OE3GOD/NCDXF-Clock/docs/DSC_0188.jpg

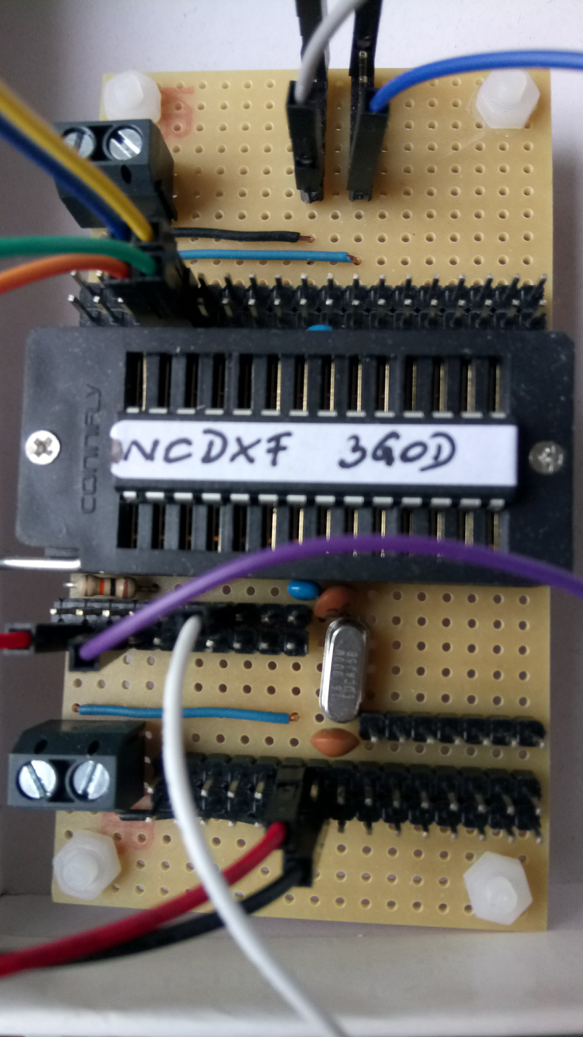
docs/DSC_0188.jpg
