OE3GOD/NCDXF-Clock/docs/DSC_0118.jpg

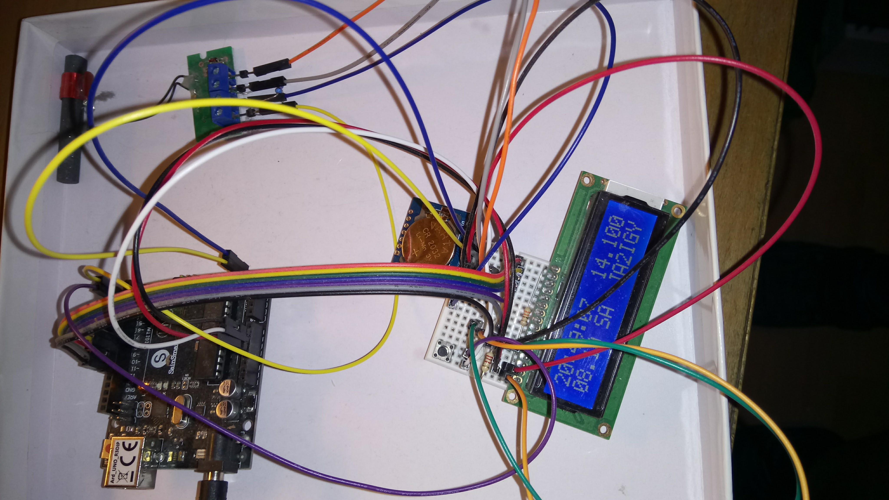
docs/DSC_0118.jpg
