OE3GOD/NCDXF-Clock/README.md

# NCDXF-Clock
UTC Clock for the Shack and gives Info on the NCDXF Beacons using DCF77 and RTC

Uses
Arduino Uno

RTC Module (by Semaf electronics Vienna)

DCF77 Module (by Conrad electronics Vienna)

I2C LCD Display (16 x 2) (by Semaf electronics Vienna)
