OE3GOD/NCDXF-Clock/docs/DCF77 Funkuhr OE3GOD.docx

# DCF77 gesteuerte Stationsuhr und NCDXF-Bakenmonitor

Gerald Moritz, OE3GOD

Zusammenfassung

Seit mehr als zehn Jahren gibt es den „Arduino“ am Markt. Dabei handelt es sich um eine Mikrocontrollerentwicklungsplattform, die wegen ihrer einfachen Handhabung immer beliebter wird.

Im Internet findet man dafür vermehrt sehr interessante Anwendungen auch für den Amateurfunk. Als Einstieg wurde nach einem Projekt gesucht, das mich näher an diese Thematik heranführt aber bereits an der Funkstation einen wertvollen Beitrag leistet. Durch meine Beobachtungen des 10m Bandes kam dann rasch auch der Wunsch auf, den Sendeplan der NCDXF-Baken gemeinsam mit der Uhrzeit anzuzeigen.

DCF77

Vom Standort Mainflingen bei Frankfurt am Main werden auf der Frequenz 77,5 kHz bereits seit 1959 Zeitzeichen gesendet. Dabei wird das Trägersignal (50 KW) für 0,1 bzw 0,2 Sekunden auf 15% herabgesenkt.

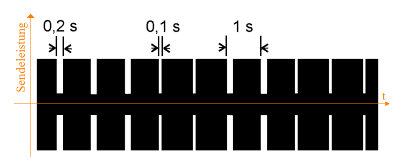
[picture p3: figure]
DCF77 Impulse

Die binäre Kodierung erfolgt dabei über die Länge der Absenkung.

0,1 Sekunde = binär 0

0,2 Sekunden = binär 1

Die Bedeutung der einzelnen Werte ist in der folgenden Zeittafel abgelegt. Insgesamt werden 59 „Werte“ übertragen, in der Sekunde 59 erfolgt keine Absenkung.

Die Werte von 0 bis 14 enthalten Lizenzpflichtige Wetterdaten bzw. Alarmierungsdaten im Katastrophenfall, zwischen 15 und 20 gibt es die Werte für die Zonenzeit (MEZ/MESZ) und etwaige Schaltsekunden, die eigentliche Zeit- und Datumskodierung beginnt ab Sekunde 20. Dabei werden die Werte immer im Voraus gesendet und mit der Sekunde 0 beginnt diese Minute.

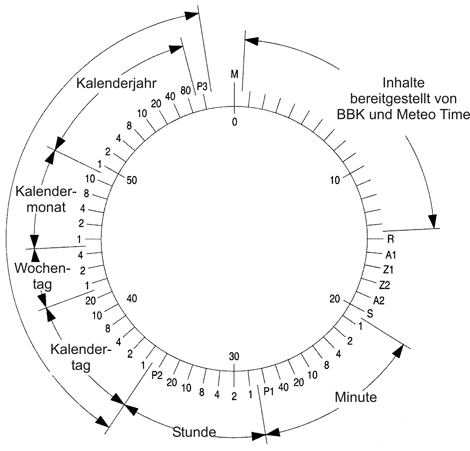
[picture p4: figure]

Beispiel für die BCD-Kodierung des Kalenderjahrs 2016:

1 | 2 | 4 | 8 | 10 | 20 | 40 | 80
0 | 1 | 1 | 0 | 1 | 0 | 0 | 0

(0 * 1) + (1 * 2) + (1 * 4) + (0 * 8) + (1*10) + (0 * 20) * (0 * 40) + (0 * 80) = 16

Die NCDXF-Baken

Das Bakennetz der DX-Foundation von Nord Kalifornien (NCDXF) besteht aus 18 zeitsynchronisierten Sendern, welche das Rufzeichen und ein Trägersignal mit unterschiedlichen Ausgangsleistungen senden.

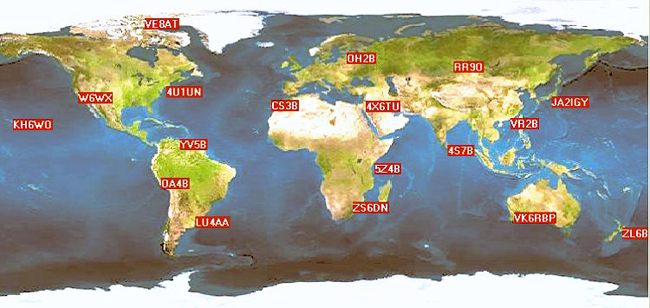
[picture p5: figure]
worldmap

Das Rufzeichen wird mit ca. 22 WpM mit 100 Watt gesendet, danach erfolgt ein 1 Sekunden Träger mit je 10 Watt, 1 Watt und 100 mW. Insgesamt arbeiten diese 18 (GPS gesteuerten) Sender je 10 Sekunden auf den jeweiligen Frequenzen, somit kann man innerhalb von 3 Minuten (180 Sekunden) die Ausbreitungsbedingungen überprüfen.

Der Sendeplan beginnend bei Sekunde Null zur vollen Stunde.

Call
4U1UN | 1 | 2 | 3 | 4 | 5
VE8AT | | 1 | 2 | 3 | 4 | 5
W6WX | | | 1 | 2 | 3 | 4 | 5
KH6RS | | | | 1 | 2 | 3 | 4 | 5
ZL6B | | | | | 1 | 2 | 3 | 4 | 5
VK6RBP | | | | | | 1 | 2 | 3 | 4 | 5
JA2IGY | | | | | | | 1 | 2 | 3 | 4 | 5
RR9O | | | | | | | | 1 | 2 | 3 | 4 | 5
VR2B | | | | | | | | | 1 | 2 | 3 | 4 | 5
4S7B | | | | | | | | | | 1 | 2 | 3 | 4 | 5
ZS6DN | | | | | | | | | | | 1 | 2 | 3 | 4 | 5
5Z4B | | | | | | | | | | | | 1 | 2 | 3 | 4 | 5
4X6TU | | | | | | | | | | | | | 1 | 2 | 3 | 4 | 5
OH2B | | | | | | | | | | | | | | 1 | 2 | 3 | 4 | 5
CS3B | 5 | | | | | | | | | | | | | | 1 | 2 | 3 | 4
LU4AA | 4 | 5 | | | | | | | | | | | | | | 1 | 2 | 3
OA4B | 3 | 4 | 5 | | | | | | | | | | | | | | 1 | 2
YV5B | 2 | 3 | 4 | 5 | | | | | | | | | | | | | | 1

1 = 14.100 kHz | 2 = 18.110 kHz | 3 = 21.150 kHz | 4 = 24.930 kHz | 5 = 28.200 kHz

Zu allen anderen Zeiten erfolgt keine Aussendung.

Die Schaltungsbeschreibung

Begonnen wurde dieses Projekt mit einem Arduino kompatiblen „SainSmart UNO R3 DIP ATMega328“, da er zum Zeitpunkt der Anschaffung günstig und lagernd war. Mittlerweile wird diese Platine nur noch zum Programmieren eigener ATMEGA328PU verwendet. Bei einem Misserfolg ist der finanzielle Schaden von ca. € 3,60 für einen einzelnen Chip minimal.

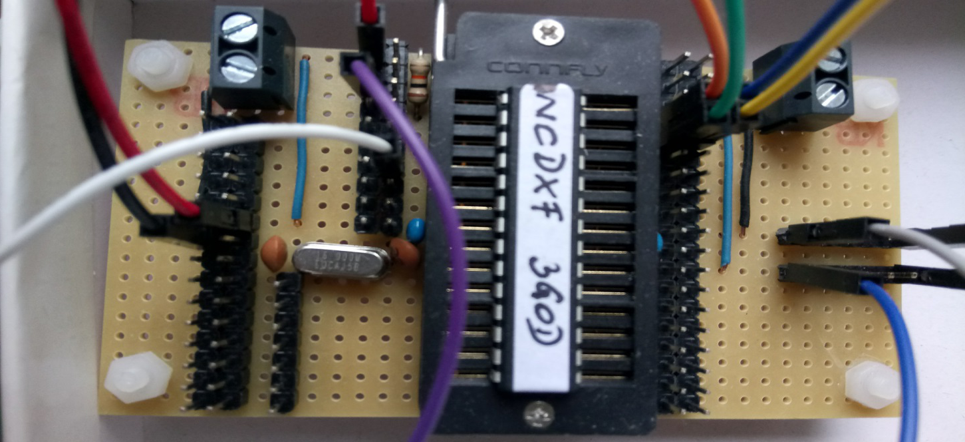
[picture p6: figure]

Um diesen Chip zum Laufen zu bringen braucht man neben der 5V Stromversorgung nur noch einen 16MHz Quarz und 2 x 22 pF Kondensatoren und hat einen platzsparenden Mikrocontroller für Aufgaben in den unterschiedlichsten Gebieten.

Taster für Bandwahl

Arduino

(UNO)

DCF77

Empfänger

LCD Display

2 x 16 Zeichen

(I²C)

DS1307

Uhrenmodul

(I²C)

Mit dem Einschalten wird zuerst geprüft, ob das Uhrenmodul vorhanden ist und ob eine Zeitinformation bereits gespeichert wurde. Im Fehlerfall wird eine Meldung angezeigt und mit dem Empfang des DCF77 Signals begonnen. Sollte eine Uhrzeit gespeichert sein, so wird diese in den Speicher geholt und angezeigt. Somit wird auch der aktuelle Bakensender ermittelt.

Abhängig von der Uhrzeit und dem eingestellten Band wird das sendende Rufzeichen berechnet. Mit den 10 Sekunden dauernden Aussendungen der 18 Sender hat man innerhalb von drei Minuten einen Überblick über die aktuellen Ausbreitungsbedingungen.

Das Uhrenmodul hat eine (angebliche) Ungenauigkeit von einer Minute pro Jahr. Alle 15 Minuten wird die Uhrzeit des Arduino durch die DCF77-Uhrzeit aktualisiert. Zu jeder vollen Stunde wird die Uhrzeit im Uhrenmodul gespeichert (falls dieses vorhanden ist). Somit sollte die Ganggenauigkeit kein Problem mehr darstellen. Ein Betrieb ohne dem RTC ist möglich.

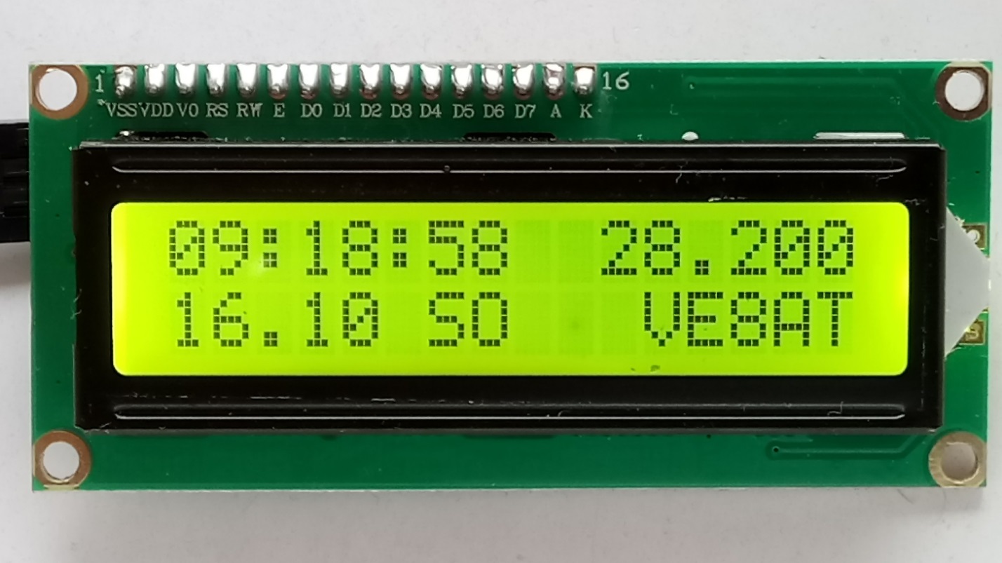
[picture p7: figure]

Beispiel der DCF77 Bakenanzeige

Am Sonntag, 16.10. um 09:18:58 (UTC) sendete VE8AT auf 28.200 kHz.

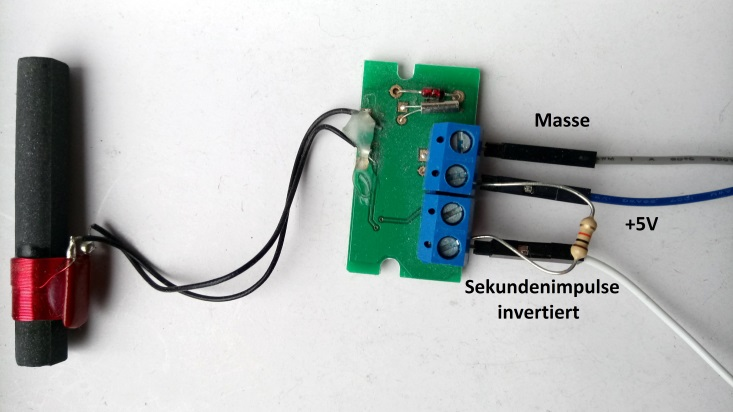
[picture p8: figure]

Viele Zeitprojekte arbeiten mit einem günstigen GPS-Modul, für den Beginn war mit die DCF77 Empfangsmöglichkeit etwas leichter zu realisieren. Der DCF77-Empfänger besteht aus einer Ferrit-Antenne und einer Miniaturplatine mit vier Anschlüssen:

1. GND
2. VCC (2,5V – 15V)
3. DCF-Ausgang
4. DCF-Ausgang invertiert

Ausgänge 3 und 4 haben einen offenen Kollektor, ein 10kOhm Pull-up Widerstand wurde verwendet.

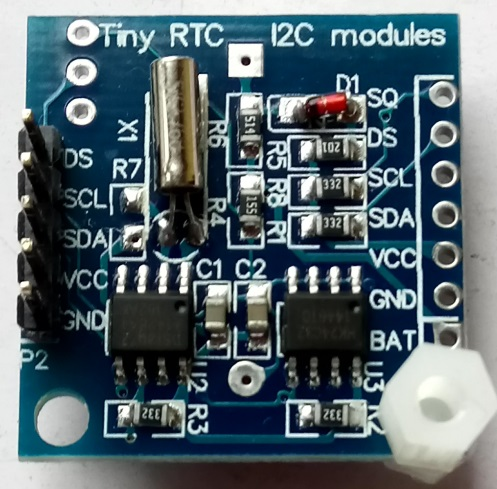
[picture p9: figure]

Das Uhrenmodul (DS1307) enthält neben der batteriegepufferten Uhr noch ein eEprom 4KByte zur freien Verwendung. Beide Teile (Uhr und Speicher) werden über den I²C-Bus angesprochen.

Über diese Zweidrahtleitung ist auch das LCD-Modul angeschlossen, da ansonsten viele der insgesamt 16 Anschlüsse am LCD-Modul zu verdrahten gewesen wären. Egal, ob die anzuzeigenden Daten über den I²C-Bus kommen, oder parallel, der Unterschied liegt nur in der Initialisierung am Beginn des Programms, die Befehle zur Anzeige sind in beiden Versionen gleich.

Die ersten Experimente machte ich mit einem (parallelen) blauen LCD-Display mit weißer Schrift. Bei der Verwendung eines I²C LCD-Moduls gibt es den Nachteil, daß die Display-Hintergrund Beleuchtung nicht dimmbar ist. Aber sogar bei hellstem Sonnenschein an der Funkstation ist die Uhrzeit und das aktuelle Bakenrufzeichen wunderbar zu lesen.

Da die Bakenstationen auf fünf Bändern senden, benötigte ich eine Umschaltung für die jeweiligen Frequenzen. In meiner Bastelkiste hatte ich einen kleinen Taster, mit diesem kann das gewünschte Bakenband ausgewählt werden. Mit einer größeren Anzeige wäre die Darstellung aller Rufzeichen auch ohne Umschaltung möglich.

Das „Blockschaltbild“ ist eigentlich bereits der gesamte Schaltplan, einzig der Pullup-Widerstand am DCF77-Modul ist nicht eingezeichnet. Die einzelnen Module erhalten ihre Spannungsversorgung vom Arduino (rot/schwarz), der I²C-Bus muss nicht von unterschiedlichen Pins zur Peripherie geführt werden, die Geräte können hintereinander geschaltet werden (gelb – SCL, orange - SDA).

Das DCF77 Modul (Pin 4) legt im Takt der ausgesendeten Impulse die Versorgungsspannung gegen Masse, daher auch der 10kOhm Widerstand (max. 1mA Schaltstrom). Am Pin3 kann über einen Transistor eine LED betrieben werden, die einzelnen Zeitimpulse (100 bzw. 200 Millisekunden) können damit sichtbar gemacht werden. Gleichzeitig kann aber auch der Empfang kontrolliert werden, im Falle einer Störung sieht man dann nur ein unkontrolliertes Aufflackern.

Für die Dekodierungsarbeit werden fertige Bibliotheken in den Code eingebunden, die man sich frei aus dem Internet holen kann. Zum Entziffern wird ein Interrupt verwendet (also eine Unterbrechung der bestehenden Verarbeitung) wenn das Signal vom Empfänger von High auf Low wechselt.

Nach dem Einschalten benötigt das Programm grundsätzlich mehrere Minuten, bis alle Zeitinformationen eingelangt sind. Wenn jedoch kein Empfang möglich ist (z.B. innerhalb des Hauses oder Störungen in der Umgebung, aber auch wenn der Zeitzeichensender wegen Defekt oder sonstigen Problemen nicht sendet) gibt es auch keine Information über die aktuell aktiven Baken.

Daher wurde die Grundschaltung um das günstige RTC (Real Time Clock) Modul DS1307 erweitert. Nach dem Ausschalten bleibt die Uhrzeit batteriegepuffert erhalten. Teurere Module bieten temperaturkompensierte Oszillatoren, diese sind aber für diese Anwendung nicht notwendig.

Apropos Versorgungsspannung: Die Programmierung inklusive der Spannungszufuhr erfolgt über die USB-Schnittstelle, beim Betrieb muß jedoch ein stabilisiertes Netzteil bzw. Batterie verwendet werden, bei USB-Versorgung hat die Uhr bisher nicht funktioniert. Für diesen Zweck hat die Arduino-Platine einen eigenen Stromanschluss (7-12 Volt). Aktuell gibt es diese Uhr nur als Prototyp, ein Gehäuse ist in Arbeit.

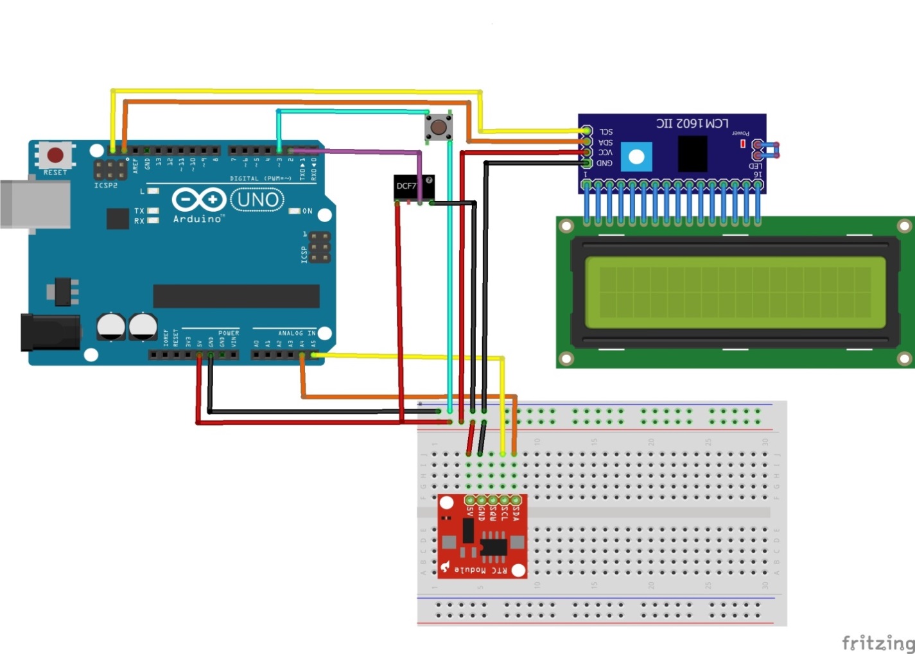
[picture p10: figure]

Anmerkungen zum Source-Code:

Dies ist mein erstes Arduino-Projekt, es kann sicherlich noch Unsicherheiten bei diversen Definitionen geben, diese werden im Laufe der Zeit sicher korrigiert und der Code verbessert werden.

Der Code kann auch auch vie email (oe3god@gmx.at) angefordert werden.

verwendete Bauteile:

SainSmart UNO R3 DIP ATMega328 Conrad ( 1359108 – 62)

bzw. ATMEGA 328P-PU Conrad (155197 – 62)

Kabel, Breadboard, Widerstände, Taster,

LCD-Display (blau/weiß) aus dem Paket

„Arduino Lernpaket Conrad Components

Arduino™ verstehen und anwenden“

Conrad (1384145 – 62)

DCF Empfänger Modul Conrad (641138 – 62)

DS1307 Real Time Clock Semaf electronics (ser00171)

I²C LCD Modul Semaf electronics (ser00054)

Quellen:

https://www.arduino.cc/

http://www.ptb.de/cms/ptb/fachabteilungen/abt4/fb-44/ag-442/verbreitung-der-gesetzlichen-zeit/dcf77/zeitcode.html

https://www.ptb.de/cms/fileadmin/internet/fachabteilungen/abteilung_4/4.4_zeit_und_frequenz/4.42/dcf77.pdf

https://de.wikipedia.org/wiki/DCF77

http://www.bayern-online.com/v2261/artikel.cfm/203/DCF77.html

http://www.ncdxf.org/pages/beacons.html

DCF77 Uhr – OE3GOD Seite 7 von 7
