OE3GOD/NCDXF-Clock/docs/DSC_0120.jpg

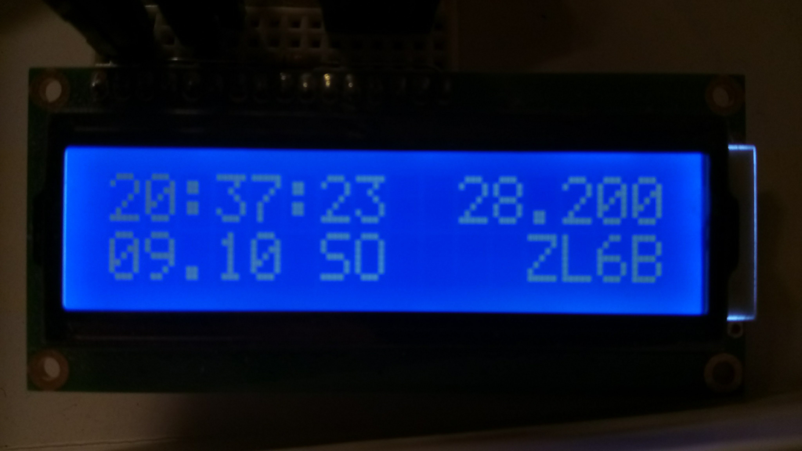
docs/DSC_0120.jpg
