OE3GOD/NCDXF-Clock/docs/DSC_0186.jpg

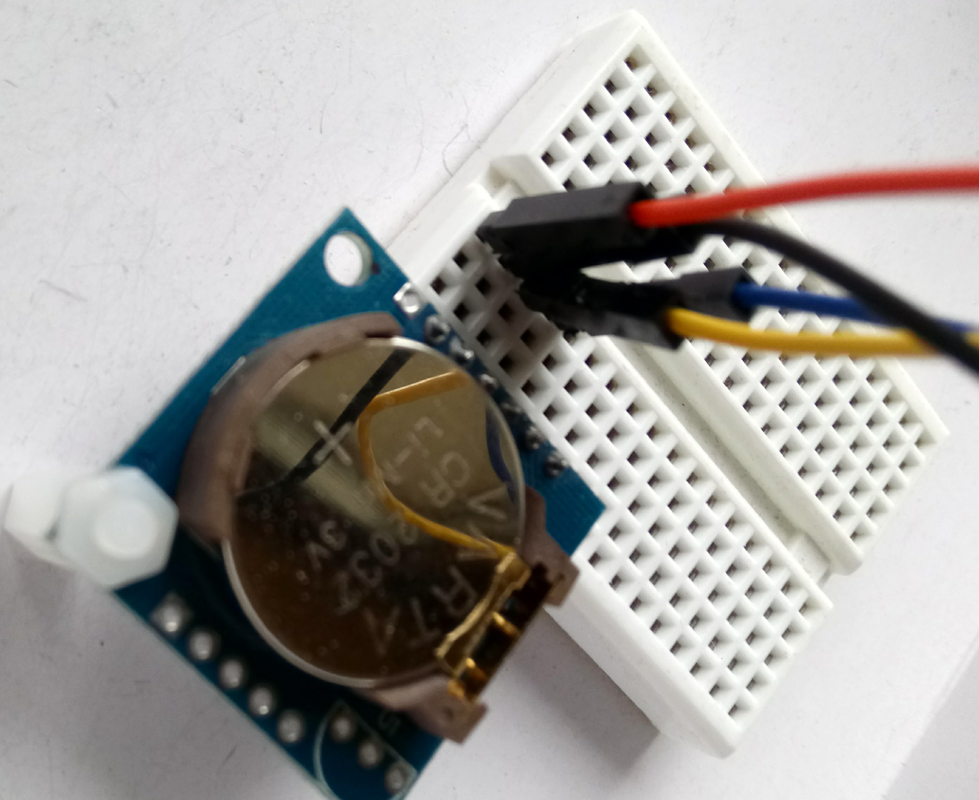
docs/DSC_0186.jpg
